seunyboyxu/Spyder_Hexapod/cad/print/stl/02_Plain_lid_x1.stl

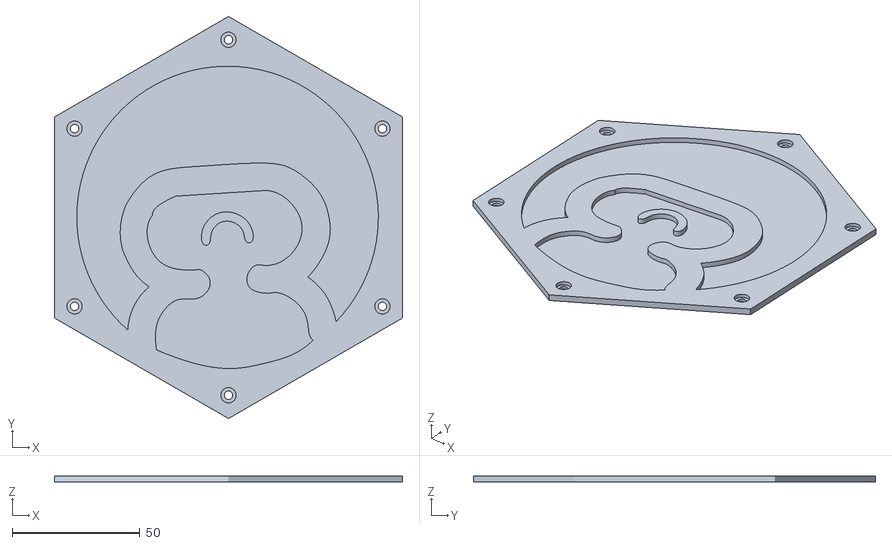
[picture p2: CAD file, 2026-10-18]
cad/print/stl/02_Plain_lid_x1.stl
136.0 x 157.0 x 2.50
