seunyboyxu/Spyder_Hexapod/cad/print/stl/04_Hip_rear_pivot_v2_x6.stl

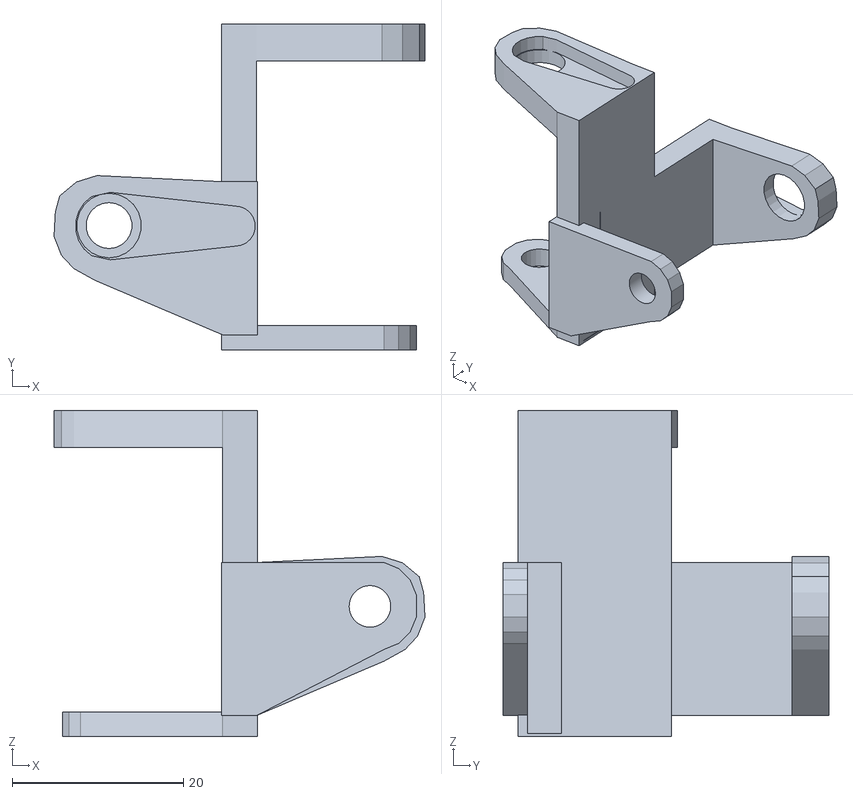
[picture p3: CAD file, 2026-10-18]
cad/print/stl/04_Hip_rear_pivot_v2_x6.stl
43.3 x 38.1 x 38.1
