seunyboyxu/Spyder_Hexapod/cad/print/stl/05_Thigh_x6.stl

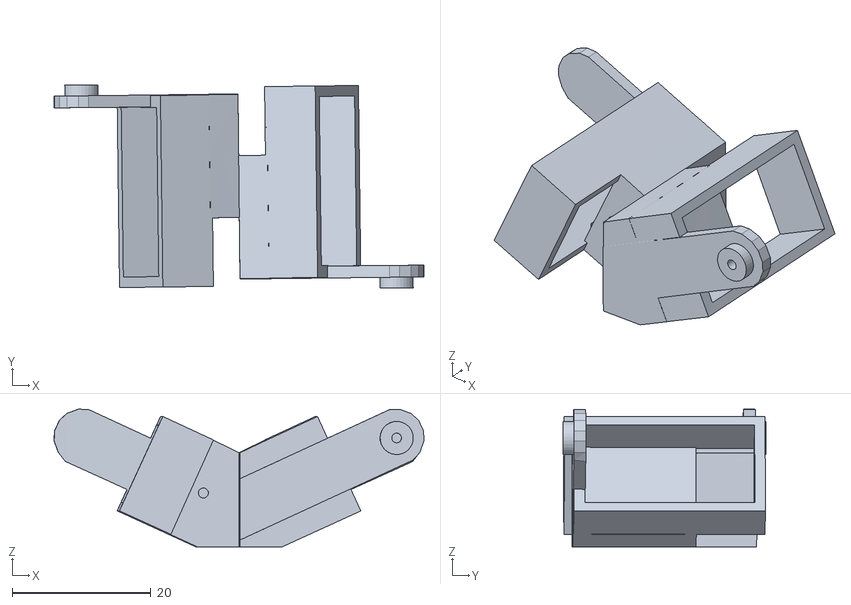
[picture p4: CAD file, 2026-10-18]
cad/print/stl/05_Thigh_x6.stl
53.3 x 29.3 x 19.8
