seunyboyxu/Spyder_Hexapod/cad/print/stl/Backing-pivot-original-PRINT.stl

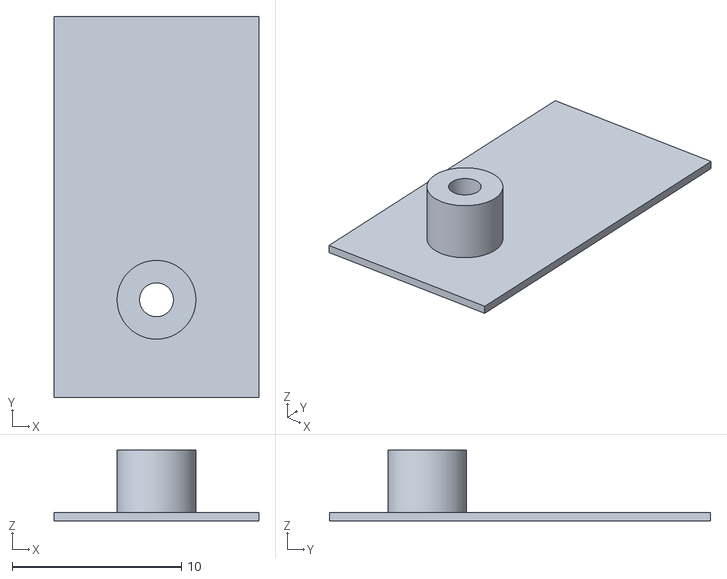
[picture p5: CAD file, 2026-10-18]
cad/print/stl/Backing-pivot-original-PRINT.stl
12.1 x 22.5 x 4.18
