seunyboyxu/Spyder_Hexapod/cad/print/stl/06_Foot_x6.stl

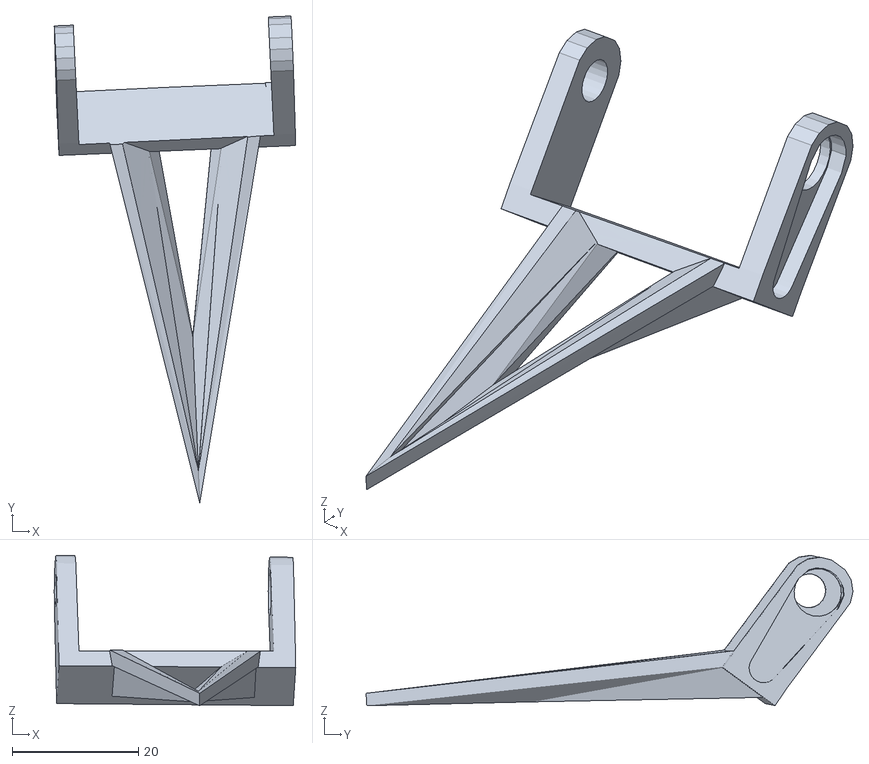
[picture p6: CAD file, 2026-10-18]
cad/print/stl/06_Foot_x6.stl
38.3 x 77.2 x 23.8
