seunyboyxu/Spyder_Hexapod/cad/print/stl/01_Chassis_x1.stl

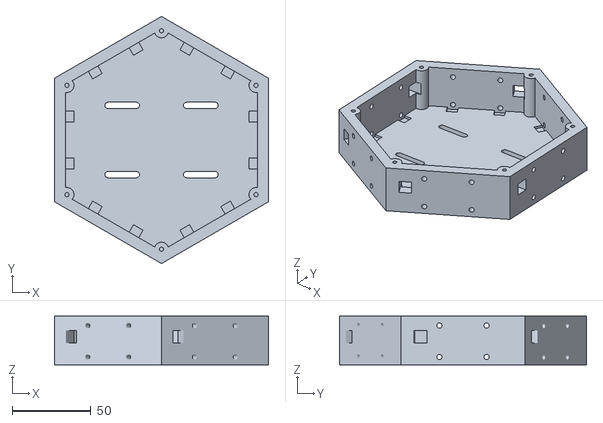
[picture p7: CAD file, 2026-10-18]
cad/print/stl/01_Chassis_x1.stl
136.0 x 157.0 x 31.0
