seunyboyxu/Spyder_Hexapod/cad/print/stl/Fixed-screw-mount-PRINT.stl

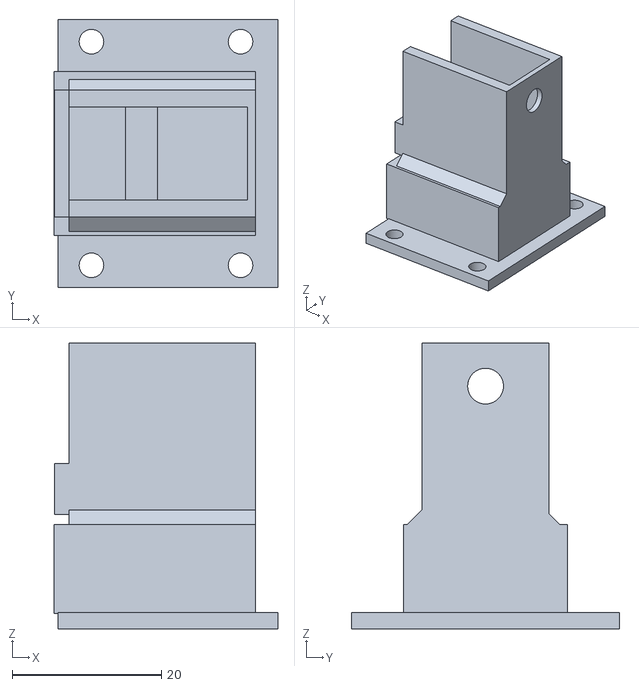
[picture p8: CAD file, 2026-10-18]
cad/print/stl/Fixed-screw-mount-PRINT.stl
30.0 x 36.0 x 38.4
