seunyboyxu/Spyder_Hexapod/(list of files, cad)

Other CAD files:
cad/fusion/Spyder-complete-six-leg-assembly.f3d
cad/fusion/Spyder-leg-fixed-screw-mount.f3d
