seunyboyxu/Spyder_Hexapod/docs/verification/2026-10-28-esp32-crawl.md

# quadpod crawl gait sketch — 28 October 2026

New folder `firmware/spyder_esp32_ble_crawl` (BLE `Spyder-Crawl-BLE`, v1.0): the walking sketch with `Walk.cpp`, `Walk.h` and `WalkConfig.h` replaced by the step sequences of [hpsaturn/quadpod](https://github.com/hpsaturn/quadpod/blob/master/src/servos.cpp) (SunFounder crawling-robot lineage). Existing sketches are unchanged, following the owner rule to add walking code as new folders.

## Design evidence

- **Lift order.** A static-stability sweep over all 24 lift orders on Spyder's stance found quadpod's forward and back orders tied for best. Its left and right orders are among the best. This confirms the leg mapping (quadpod 0 FR, 1 RR, 2 FL, 3 RL → Spyder 1, 3, 0, 2).
- **Stance and margin.** Spyder's front/rear-station stance is long and narrow, and gives only ~5 mm stability margin unmodified. quadpod's square stance gives ~17 mm. A lean before each lift (all feet down) restores ≥12 mm.
- **Lift height.** Default ±30° knee/foot limits cap lift at about 10 mm at the 85/−60 mm stand. 20 mm (quadpod's) reaches ~37–43°.

## Host evidence

`bash scripts/test-esp32-crawl.sh` passed:

| Direction | Margin | Largest joint | Fastest joint | Cycle |
|---|---|---|---|---|
| walk | 12.2 mm | 27.0° | 93°/s | 5.2 s |
| back | 12.2 mm | 27.0° | 93°/s | 5.2 s |
| left | 12.1 mm | 25.1° | 85°/s | 4.1 s |
| right | 12.1 mm | 25.1° | 85°/s | 4.1 s |

- **Direction changes** (walk↔back, left→right, walk→left, right→back): ≥12.1 mm margin, ≤27.1°.
- **Controller:** `walk 3` returned to the same standing pulses after 20.1 s.
- **Copies:** the copied four-leg suites pass, and the shared files are byte-identical to the walking sketch.
- **Aggregate:** `bash scripts/test-esp32.sh` passed.

## Not done

- **ESP32 compile/link of the new folder.** This session could not download the espressif32 platform. Run `bash scripts/build-esp32-crawl.sh` or compile in Arduino IDE before upload.
- **All physical behaviour.**
- **Licence.** No repository licence was chosen. quadpod is GPL-3.0; no quadpod source is copied here, only its sequences with attribution.
