seunyboyxu/Spyder_Hexapod/docs/verification/2026-10-27-esp32-leg-test.md

# ESP32/PCA9685 one-leg test — verification

Historical verification snapshot. For current publication status, retained tests and source layout, see [project state](../project-state.md) and [publication checks](2026-10-28-esp32-publication.md).
27 October 2026. Local candidate on `feat/esp32-pca9685-servo-test`; no GitHub push, hardware upload or motor movement performed.

The owner's correction supersedes the earlier one-motor scope: use one positional-servo leg on PCA9685 channels0/1/2, with SDA GPIO21 and SCL GPIO22. The sketch is `firmware/spyder_esp32_leg_test/spyder_esp32_leg_test.ino`. The previous Uno/ESP32 motor candidates, old downloads and existing source/tests remain intact.

## Fresh evidence

| Check | Result |
|---|---|
| `bash scripts/test-esp32-leg.sh` | All **eight reported groups** passed with AddressSanitizer/UndefinedBehaviorSanitizer and compiler warnings treated as errors. |
| `bash scripts/build-esp32-leg.sh` | Actual original ESP32 Arduino-framework compile/link succeeded: **1,133,665 bytes flash**, **40,484 bytes static RAM**, within the default1,310,720-byte application partition. |
| `npm test` | Existing console suite: **39 passed**, zero failures. |
| Source equivalence | `LegTest.h` and `LegTest.cpp` are byte-for-byte copies of the previous tested one-leg controller. |
| Independent review | Fresh read-only reviewer ran the new tests and inspected the adaptation; **no material actionable findings**. |
| Whitespace and package | Tracked diff and new-file whitespace checks passed; ZIP CRC/source equivalence and SHA256 manifest checked at delivery. |

Build versions: PlatformIO6.1.18/espressif32 platform6.12.0, Arduino ESP32 **2.0.17**, Adafruit PWM Servo Driver **3.0.2**, Adafruit BusIO **1.17.4**. PlatformIO compiles the real Arduino sketch and ESP32 framework; a GUI Arduino IDE session was not run. Static RAM figures exclude dynamic Bluetooth/FreeRTOS heap and task-stack usage.

## Coverage

- Reused controller: isolated per-joint calibration, bounds/strict commands, direction/reference checks, inverse kinematics checked by independent forward kinematics, supported standing/partial extension, finite cycles and complete-path preflight.
- Timing: STOP holds and cancels, OFF releases, fractional speeds, delayed-loop step cap and millisecond wrap.
- Record codec: CRC/version/semantic validation, all256 individual bit corruptions, output-off-only application.
- Three-channel hardware adapter: all16 channels full-off at initialization; only0–2 may activate; one joint can detach without changing another; global release inhibits OE before I2C cleanup; disconnect at the attach boundary prevents re-enabling; I2C errors latch disabled.
- Actual-sketch host harness: USB calibration/poses/step and stop/release; source-specific Bluetooth status replies; valid saved calibration loads at boot without activation; detached-only save/load; failed storage and corrupted records; UART errors and Bluetooth RX overflow hold/cancel; disconnect releases every joint; later per-joint activation does not wake released channels; write faults disable the whole leg.

The new runner first failed because the ESP32 leg adaptation was absent. Reused controller/parser checks then passed against the new copies; adapter and actual-sketch checks failed until their corresponding implementation was added. Previous one-motor overflow handling was retained through an application-owned bounded Bluetooth queue and UART receive-error callbacks.

## Limits and physical checks

Host doubles substitute I2C/GPIO, UART, Bluetooth and scheduler boundaries. They do not reproduce real FreeRTOS scheduling, execute the reply worker, establish radio pairing/loss/congestion timing, measure PWM oscillator accuracy, validate reset/OE electrical behavior, assess supply performance or prove mechanical clearance/balance. The independent reviewer explicitly left these physical/concurrency properties unverified.

The leg retains its earlier Servo-library degree scale (**90° requests1472us**), unlike the separate one-motor tester's nominal90°=1500us. Its hard electrical envelope remains1000–2000us, initial limits60–120°, absolute allowed45–140°. No full-range sweep is provided for an assembled leg.

Use the included wiring/calibration README. In addition to confirmed SDA21/SCL22, connect OE toGPIO23 and fit a pull-up that holds it HIGH during reset. A board's OE pull-down can defeat a10k pull-up; the README explains the confirmed10k-pull-down/1k-pull-up case and requires voltage verification with servo power off. Use separate suitable servo power with common ground; keep the motor supply off for upload/reset.

The estimated27.5/55/74mm geometry and pose values were reused, not newly measured. Secure the body mount, start with the foot suspended, physically align/check each joint, then test `stand`, `straight` and one `step 1` individually. STOP/OFF and radio-disconnect checks are part of the owner's test. Save only after confirming calibration; loading never activates output. The owner provides `show` and observations before publication.
