seunyboyxu/Spyder_Hexapod/docs/superpowers/plans/2026-10-27-esp32-leg-test.md

# ESP32/PCA9685 one-leg adaptation

The owner corrected the approved one-motor scope to **one three-servo leg**, explicitly requested implementation/reuse, and specified PCA9685 channels **0/1/2**, SDA GPIO21 and SCL GPIO22. Proceed with that correction without another design-approval cycle.

## Contract

Create `firmware/spyder_esp32_leg_test/`, preserving both previous candidates and all existing source/tests. Hip=channel0, knee/thigh=1, foot=2. Reuse the earlier Uno one-leg geometry/calibration/pose controller and strict two-input parser, with a checked PCA9685 adapter and the ESP32 Bluetooth/USB transport already verified. OE remains GPIO23 with verified pull-up. All sixteen outputs are off at boot; only channels0–2 may subsequently activate. Bluetooth disconnect, `off` and urgent `!` inhibit all three outputs; STOP holds current commands. I2C faults latch until reset. Line/UART/radio buffer integrity errors hold and cancel pending input.

Preserve the leg controller's tenths-of-degree calibration and default Servo-library scale: 90°=1472us; hard 1000–2000us envelope, initial limits60–120°, adjustable only inside45–140°. This intentionally differs from the separate one-motor tester's nominal90°=1500us. There is no automatic import between these test programs. Estimated geometry remains27.5/55/74mm; each joint must be physically aligned/direction-checked before standing, partial straightening or finite1–3 step cycles. No assembled-leg full-range sweep is included.

Provide `cal/move/zero/test/flip/check/limits/speed`, `stand/straight/step`, `show/help/stop/off/!`, and detached-only `save/load` using a separate ESP32 Preferences namespace with the existing version/CRC/semantic-checked calibration packet. Loading never activates output. USB115200/Newline and Bluetooth Classic device `Spyder-Leg-Test` share behavior with separate input/reply routing. Do not upload or push before the owner's physical test.

## Execution and evidence

- [x] Demonstrate missing adaptation with the new test runner and adapter/integration checks.
- [x] Copy the earlier leg controller unchanged; adapt only the new parser copy to unsigned-byte validation, external cancellation and new-session reset. Run the earlier controller/parser tests against the new files.
- [x] Implement a three-channel PCA output adapter; cover per-joint isolation/release, all-off boot, failures and disconnect during attach.
- [x] Adapt the ESP32 sketch's checked transport, replies and fault/disconnect handling; add actual-sketch host checks for calibration, poses/finite steps, stop/release, storage and both input error paths.
- [x] Compile/link for the original ESP32 Arduino target; run affected native tests and existing npm suite.
- [x] Obtain a fresh read-only review, fix material findings with regression checks, document exact commands/power/wiring and package the complete Arduino sketch in a new ZIP. Report hardware limits accurately; retain previous downloads.
