seunyboyxu/Spyder_Hexapod/firmware/spyder_esp32_ble_crawl/NvSettings.cpp

#include "NvSettings.h"
#include <Preferences.h>
namespace fourleg {
bool loadCalibration(Settings &settings) {
  Preferences preferences;
  if(!preferences.begin("spyder-four",true)) return false;
  uint8_t bytes[SavedSize];
  bool valid=preferences.getBytesLength("cal")==SavedSize &&
    preferences.getBytes("cal",bytes,sizeof(bytes))==sizeof(bytes);
  preferences.end();
  return valid && decodeSettings(bytes,settings);
}
bool saveCalibration(const Settings &settings) {
  uint8_t bytes[SavedSize];
  if(!encodeSettings(settings,bytes)) return false;
  Preferences preferences;
  if(!preferences.begin("spyder-four",false)) return false;
  bool saved=preferences.putBytes("cal",bytes,sizeof(bytes))==sizeof(bytes);
  preferences.end(); return saved;
}
}
