seunyboyxu/Spyder_Hexapod/(commit log)

2026-10-18 All Spyder Parts
    [01_Chassis_x1.stl, 02_Plain_lid).stl, 04_Hip_rear_pivot_v2_x6.stl, 05_Thigh_x6.stl, 06_Foot_x6.stl, Backing-pivot-original-PRINT.stl, Fixed-screw-mount-PRINT.stl, Spyder-complete-six-leg-assembly.f3d]
2026-10-18 Organize Spyder handover, calibration software and CAD sources
    [01_Chassis_x1.stl, 02_Plain_lid_x1.stl, 04_Hip_rear_pivot_v2_x6.stl, 05_Thigh_x6.stl, 06_Foot_x6.stl, Backing-pivot-original-PRINT.stl, Fixed-screw-mount-PRINT.stl, Spyder-complete-six-leg-assembly.f3d]
2026-10-19 Add individual unloaded servo centering and range sweep
2026-10-22 new calibration and final standing/walking code
2026-10-23 Add standalone standing and walking sketch
    New Arduino sketch firmware/spyder_walk for the four-leg Uno build: leg
    inverse kinematics, sit/stand poses, a slow creep gait with body lean
    (forward, back, turn left/right), serial commands, runtime trims saved
    at EEPROM 512+, and an A0 button for running without a PC. All lengths,
    leg directions and gait settings are in Config.h; leg lengths are
    estimates from the CAD. No existing files are changed.
    PC tests in tests/walk (scripts/test-walk.sh) check IK against forward
    kinematics, one foot up at a time, static stability margin and smooth
    stopping.
    Claude-Session: https://claud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
    [Walk.cpp, Walk.h]
2026-10-23 Fix Arduino IDE build: 'Saved' does not name a type
    The IDE adds function prototypes above the first function, before the
    EEPROM struct was declared. Move the struct into Trims.h and qualify
    Angles in writeAngles' signature so the prototypes always compile.
    Claude-Session: https://claude.ai/code/session_01EKFdU9LV5t7R5fskRfS67f
2026-10-23 Add simple walking sketch built on Seun's stand pose
    firmware/spyder_simple_walk uses Seun's pins (KNEE2 on D1) and his
    working per-leg stand angles, so no calibration step is needed. A creep
    gait moves hips and knees a few degrees around that pose, one leg at a
    time, with forward, back, left and right turns, a direction-check mode,
    Serial Monitor commands (receive only, so D1 stays free for the servo)
    and an optional A0 button.
    Checked in simavr: stand pulses match Seun's angles on all 12 pins
    including D1, walks start and end in the stand pose, and stop/off work.
    Claude-Session: https://claude.ai/code/session_01EKFdU9LV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
2026-10-23 Simple walk: start leg 2 knee at 90 and add live joint adjust
    Seun's sketch never really drove KNEE2 on pin 1 (Serial TX held it
    high), so its 140 degree value pushed the knee past its stop once this
    sketch drove the pin. Start it at 90 and add hip/knee/foot <leg> <deg>
    commands to find the right standing angles live.
    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
2026-10-26 Document four-leg Bluetooth test controller design
2026-10-27 Document ESP32 PCA9685 single-servo test design
2026-10-28 Publish ESP32 PCA9685 sketches and retire legacy Uno stack
2026-10-28 Add ESP32 BLE walking sketch with a balanced crawl gait
    firmware/spyder_esp32_ble_walk copies the four-leg BLE controller v1.1
    and adds walk/back/left/right [N] and halt. One foot lifts at a time
    while the body leans over the other three; walks start from and end in
    the v1.1 stand pose. A whole cycle is checked against every joint's
    saved limits before anything moves, joint speed is capped while
    walking, and stop/off/BLE loss behave as in v1.1. Calibration is shared
    with the four-leg test (Preferences spyder-four/cal).
    Host checks in tests/esp32_walk (scripts/test-esp32-walk.sh): balance
    margin, one foot up, joint limits and speeds for all four directions,
    controller commands, and the sketc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
2026-10-28 Validate walking transitions and integrate Ryan's ESP32 controller
2026-10-28 Add quadpod/SunFounder crawl gait sketch (spyder_esp32_ble_crawl)
    New sketch folder: the walking controller with its gait generator replaced
    by quadpod's step sequences (SunFounder crawling-robot lineage) in Spyder's
    body frame, plus a lean before each lift for Spyder's narrow stance.
    Shared controller files stay byte-identical to spyder_esp32_ble_walk.
    Host tests, PlatformIO env, build/test scripts and docs added.
    ESP32 compile and all physical behaviour still to be verified.
    Claude-Session: https://claude.ai/code/session_015qSvBQYHh914HGza7Qrvea
    [BleUart.cpp, BleUart.h, CommandInputs.cpp, CommandInputs.h, FourLegSafety.h, FourLegTest.cpp, FourLegTest.h, LegTest.cpp]
